bijiuni/pulse_oximeter/(list of files, drawings)

Other design files:
PCB board.pcb
